tractiming/trac-pcb/trac.ods

Sheet: Sheet1
ID | Description | Value | # | Schematic #s | Package | SMD/Through Hole | Digikey Part #
1 | Capacitor | 0.01uF | 3 | C9, C14, C15 | SM0805 | SMD | 445-1343-1-ND
2 | Capacitor | 0.1uF | 10 | C1, C2, C18, C7, C10 | SM0805 | SMD | 1276-1007-1-ND
3 | Resistor | 1.6k | 1 | R28 | SM0805 | SMD | P1.60KCCT-ND
4 | Capacitor | 1000uF | 1 | C20 | Through Hole | TH | 493-1065-ND
5 | Capacitor | 100uF | 1 | C8 | Through Hole | TH | 587-3978-1-ND
6 | Inductor | 100uH | 1 | L1 | Through Hole | TH | 513-1673-ND
7 | Resistor | 10k | 2 | R7, R11 | SM0805 | SMD | P10.0KCCT-ND
8 | Capacitor | 10uF | 2 | C3, C21 | SM0805 | SMD | 490-3340-1-ND
9 | Resistor | 15k | 1 | R19 | SM0805 | SMD | P15KACT-ND
10 | Resistor | 1k | 4 | R2, R3, R4, R5 | SM0805 | SMD | P1.0KADCT-ND
11 | Resistor | 2.21k | 4 | R24, R29, R31, R33 | SM0805 | SMD | P2.21KCCT-ND
12 | Resistor | 2.2k | 3 | R1, R16, R21 | SM0805 | SMD | P2.2KACT-ND
13 | Resistor | 2.61k | 1 | R25 | SM0805 | SMD | P2.61KDACT-ND
14 | Resistor | 2.7k | 3 | R22, R26, R27 | SM0805 | SMD | P2.7KACT-ND
15 | Resistor | 2.8k | 1 | R35 | SM0805 | SMD | P2.8KDACT-ND
16 | Resistor | 22 | 3 | R13, R15, R18 | SM0805 | SMD | P22.0CCT-ND
17 | Capacitor | 220uF | 3 | C19, C12, C13 | Through Hole | TH | 493-1579-ND
18 | Inductor | 25uH | 1 | L4 | Through Hole | TH | 495-5605-1-ND
19 | Resistor | 3.57k | 2 | R30, R32 | SM0805 | SMD | P3.57KCCT-ND
20 | Resistor | 3.6k | 2 | R8, R9 | SM0805 | SMD | P3.6KACT-ND
21 | CAP | 33pF | 3 | C4, C5, C6 | SM0805 | SMD | 1276-1105-1-ND
22 | Resistor | 4.7k | 3 | R6, R12, R17 | SM0805 | SMD | P4.7KACT-ND
23 | Resistor | 4.99k | 2 | R23, R34 | SM0805 | SMD | P4.99KCCT-ND
24 | CAP | 470uF | 3 | C11, C16, C17 | Through Hole | TH | P14419-ND
25 | Resistor | 47k | 3 | R10, R14, R20 | SM0805 | SMD | P47KACT-ND
26 | Inductor | 50uH | 2 | L2, L3 | Through Hole | TH | 513-1548-ND
27 | Alien Power Connection | - | 1 | U5 | - | - | N/A
28 | Battery Connection | - | 1 | P1 | - | - | N/A
29 | DB9 Male Serial Connector | - | 1 | J1 | Through Hole | TH | A35107-ND
30 | Schottky Diode | - | 4 | D6, D7, D8, D9 | TO-220-2 | TH | MBR745GOS-ND
31 | MAX3232 | - | 1 | U3 | 16 pin dip | TH | MAX3232CPE+-ND
32 | LED | - | 4 | D1, D2, D4, D5 | T-1 (3mm) | TH | 160-1958-ND
33 | LT1074 | - | 2 | U8, U9 | TO-220-7 | TH | LT1074CT7#PBF-ND
34 | LT1176 | - | 2 | U6, U10 | 8 Pin DIP | TH | LT1176CN8#PBF-ND
35 | LT1965 | - | 1 | U11 | TO220-5 | SMD | LT1965ET#PBF-ND
36 | LTC2951-1 | - | 1 | U7 | TSOT23-8 | SMD | LTC2951ITS8-1#TRMPBFCT-ND | From protoadvantage
37 | NPN Transistor | - | 3 | Q1, Q2, Q3 | SOT23 | SMD | MMBT2222ATPMSCT-ND
38 | PIC32MX250F128B Microcontroller | - | 1 | U2 | 28 Pin DIP | TH | PIC32MX250F128B-I/SP-ND
39 | Pickit3 Header | - | 1 | U1 | 5x1 Male Header | TH | S9014E-05-ND
40 | SIM Slot (Hinged) | - | 1 | S1 | Hinged SIM slot | SMD | WM3284CT-ND
41 | Pushbutton Switch (Mom. Closed) | - | 1 | SW1 | Wired through case | N/A | GH7270-ND
42 | UC15 Header | - | 1 | U4 | 30x2 Female Header (1.27 mm pitch) | SMD | 609-3781-ND
43 | Alien power plug | - | 1 | - | - | - | 502-05CL5MX 05CL5MX 5 PIN MALE PLUG (MOUSER)

Sheet: v2
ID | Schematic #s | # | Value | Footprint | Digikey Part # | Manufacturer part # |  | Description | done
1 | U12 | 1 |  |  | H9161CT-ND | U.FL-R-SMT(10) |  | Antenna mount | 1
2 | C4, C5, C6 | 3 | 33 pF | 0805 | 1276-1105-1-ND | CL21C330JBANNNC |  | Capacitor | 1
3 | C9, C14, C15 | 3 | 0.01 uF | 0805 | 445-1343-1-ND | C2012X7R2A103K085AA |  | Capacitor | 1
4 | C1, C2, C18, C7 | 4 | 0.1 uF | 0805 | 1276-1007-1-ND | CL21F104ZBCNNNC |  | Capacitor | 1
5 | C10 | 1 | 1 uF | 0805 | 1276-1066-1-ND | CL21B105KAFNNNE |  | Capacitor | 1
6 | C3, C21 | 2 | 10 uF | 0805 | 490-3340-1-ND | GRM219R60J106KE19D |  | Capacitor | 1
7 | C8 | 1 | 100 uF | 0805 | 493-1210-ND | UVR2F101MHD |  | Capacitor | 1
8 | C19, C12, C13 | 3 | 220 uF | Through Hole | 493-1579-ND | UHE1V221MPD6 |  | Capacitor | 1
9 | C11, C16, C17 | 3 | 470 uF | Through Hole | P14419-ND | EEU-FR1E471 |  | Capacitor | 1
10 | C20 | 1 | 1000 uF | Through Hole | 493-1065-ND | UVR1E102MPD |  | Capacitor | 1
11 | R13, R15, R18 | 3 | 22 Ohms | 0805 | P22.0CCT-ND | ERJ-6ENF22R0V |  | Resistor | 1
12 | R2, R3, R4, R5 | 4 | 1 kOhms | 0805 | P1.0KADCT-ND | ERJ-P06J102V |  | Resistor | 1
13 | R28 | 1 | 1.6 kOhms | 0805 | P1.60KCCT-ND | ERJ-6ENF1601V |  | Resistor | 1
14 | R1, R16, R21 | 3 | 2.2 kOhms | 0805 | P2.2KACT-ND | ERJ-6GEYJ222V |  | Resistor | 1
15 | R24, R29, R31, R33 | 4 | 2.21 kOhms | 0805 | P2.21KCCT-ND | ERJ-6ENF2211V |  | Resistor | 1
16 | R25 | 1 | 2.61 kOhms | 0805 | P2.61KDACT-ND | ERA-6AEB2611V |  | Resistor | 1
17 | R22, R26, R27 | 3 | 2.7 kOhms | 0805 | P2.7KACT-ND | ERJ-6GEYJ272V |  | Resistor | 1
18 | R35 | 1 | 2.8 kOhms | 0805 | P2.8KDACT-ND | ERA-6AEB2801V |  | Resistor | 1
19 | R30, R32 | 2 | 3.57 kOhms | 0805 | P3.57KCCT-ND | ERJ-6ENF3571V |  | Resistor | 1
20 | R8, R9 | 2 | 3.6 kOhms | 0805 | P3.6KACT-ND | ERJ-6GEYJ362V |  | Resistor | 1
21 | R6, R12, R17 | 3 | 4.7 kOhms | 0805 | P4.7KACT-ND | ERJ-6GEYJ472V |  | Resistor | 1
22 | R23, R34 | 2 | 4.99 kOhms | 0805 | P4.99KCCT-ND | ERJ-6ENF4991V |  | Resistor | 1
23 | R7, R11 | 2 | 10 kOhms | 0805 | P10.0KCCT-ND | ERJ-6ENF1002V |  | Resistor | 1
24 | R19 | 1 | 15 kOhms | 0805 | P15KACT-ND | ERJ-6GEYJ153V |  | Resistor | 1
25 | R10, R14, R20 | 3 | 47 kOhms | 0805 | P47KACT-ND | ERJ-6GEYJ473V |  | Resistor | 1
26 | L4 | 1 | 25 uH | Through Hole | 495-5605-1-ND | B82133A5152M |  | Inductor | 1
27 | L2, L3 | 2 | 50 uH | Through Hole | 513-1548-ND | CTX50-2-52-R |  | Inductor | 1
28 | L1 | 1 | 100 uH | Through Hole | 513-1673-ND | CTX100-1-52-R |  | Inductor | 1
29 | D6, D7, D8, D9 | 4 |  | TO-220-2 | MBR745GOS-ND | MBR745G |  | Schottky Diode | 1
30 | D1, D2, D4, D5 | 4 |  | T-1 (3mm) | 160-1958-ND | LTL-4231N-1 | DNP | LED | 1
31 | U4 | 1 |  |  |  | UC15AA-128-NCH-STD | Consigned | Quectel UC15 | 1
32 | U8, U9 | 2 |  | TO-220-7 | LT1074CT7#PBF-ND | LT1074CT7#PBF |  | LT1074 | 1
33 | U6, U10 | 2 |  | 8 Pin DIP | LT1176CN8#PBF-ND | LT1176CN8#PBF |  | LT1176 | 1
34 | U7 | 1 |  | TSOT23-8 | LTC2951ITS8-1#TRMPBFCT-ND | LTC2951ITS8-1#TRMPBF |  | LTC2951-1 | 1
35 | Q1, Q2, Q3 | 3 |  | SOT23 | MMBT2222ATPMSCT-ND | MMBT2222A-TP |  | NPN Transistor | 1
36 | U5 | 1 |  | 4 x 1 Through Hole |  |  | DNP | Alien Power Connection | 1
37 | P1 | 1 |  | 2 x 1 Through Hole |  |  | DNP | Battery Connection | 1
38 | J1 | 1 |  | D-SUB | A35107-ND | 1734354-1 |  | DB9 Male Serial Connector | 1
39 | S1 | 1 |  | Hinged SIM slot | WM3284CT-ND | 470230001 |  | SIM Slot (Hinged) | 1
40 | SW1 | 1 |  | Wired through case | GH7270-ND | 30-102 | DNP | Pushbutton Switch (Mom. Closed) | 1
41 | U1 | 1 |  | 5 x1 Male Header | S9014E-05-ND | GRPB051VWVN-RC |  | Pickit3 Header | 1
42 | U11 | 1 |  | 5-D2PAK | LT1965EQ#PBF-ND | LT1965EQ#PBF |  | LT1965 | 1
43 | U3 | 1 |  | 16-SOIC | 296-19851-1-ND | MAX3232ECDR |  | MAX3232 | 1
44 | U2 | 1 |  | 28-SOIC | PIC32MX250F128B-I/SO-ND | PIC32MX250F128B-I/SO |  | PIC32MX250F128B Microcontroller | 1
