tractiming/trac-pcb/(commit log)

2014-12-14 Created preliminary schematic.
    [trac.sch]
2014-12-30 Saving a bunch more changes.
    [trac.sch]
2015-02-07 Split schematic into multiple sheets.
    [fadd1.sch, power_sht.sch, trac.sch]
2015-02-07 Generated netlist and began running cvpcb.
    [power_sht.sch, trac.sch]
2015-02-11 Updated resistor values and serial communication circuit on schematic.
    [power_sht.sch, trac.sch]
2015-03-23 Updated footprints and started board layout.
    [power_sht.sch, trac.brd, trac.sch]
2015-03-24 Saving progress
    [power_sht.sch, trac.brd, trac.sch]
2015-03-31 saving progress for the night.
    [$savepcb.brd, power_sht.sch, trac.sch]
2015-04-02 more progress on board layout
    [$savepcb.brd, power_sht.sch, trac.brd, trac.sch]
2015-04-09 Finished routing and started bill of materials.
    [$savepcb.brd, power_sht.sch, trac.brd, trac.csv, trac.ods, trac.sch]
2015-04-12 Updating bill of materials and layout.
    [$savepcb.brd, power_sht.sch, trac.brd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]
2015-04-13 Made a few tweaks and output gerber files.
    [$savepcb.brd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]
2015-04-20 Updated serial conversion to use MAX3232, changed footprint of timer chip and 3.8V regulator.
    [$savepcb.brd, power_sht.sch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]
2015-04-21 Updated bom.
    [trac.csv, trac.ods]
2015-06-29 Fixes #3
    [$savepcb.brd, trac.brd]
2016-01-14 Make backups of version 1
    [power_sht.sch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]
2016-01-14 Correct NPN pins. Fixes # 1
    [$savepcb.brd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]
2016-02-12 Update kicad, switch to surface mount gsm
    [$savepcb.brd, bom.csv, power_sht.sch, trac-1.brd, trac-append.brd, trac-tempo.ods, trac.brd, trac.kicad_pcb]
2016-02-12 Version 2 as printed
    [battery_ind.sch, power_sht.sch, trac-tempo.ods, trac.kicad_pcb, trac.sch]
